juhum1/EID-101-C_Group3/Group3_Required_Milestones/Group3_Mechanical/Group3_CAD.md

Our full CAD can be found at the following link:

https://cad.onshape.com/documents/2cab0b1e455cba97361a3ce3/w/f83fcec6a3bfe1c423a4c53c/e/1c15cd89dac8a27a22d52bf7
