juhum1/EID-101-C_Group3/Group3_Deliverables/Group3_Gantt_Chart.md

| **Task** | **Duration (Weeks)** | **Week 1** | **Week 2** | **Week 3** | **Week 4** | **Week 5** |
|---|---|---|---|---|---|---|
| Research Components | 1 Week | X | | | | |
| Assembly & Wiring | 2 Weeks | | X | X | | |
| Programming and CAD | 3 Weeks | | | X | X |  X |
| Testing & Calibration | 2 Weeks | | | | X |  X |
