juhum1/EID-101-C_Group3/Group3_Required_Milestones/Group3_Electrical/schematic.pdf

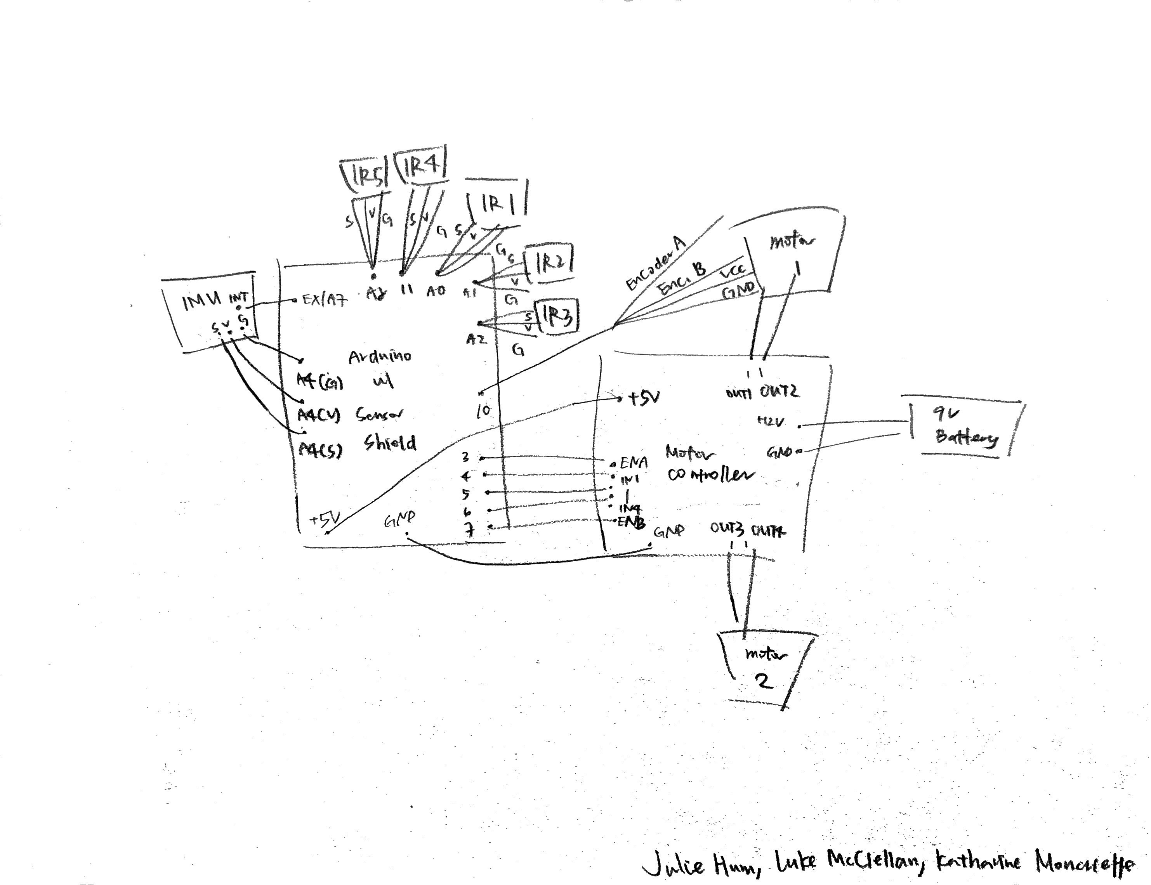
[picture p6: page 1]
