juhum1/EID-101-C_Group3/Group3_Required_Milestones/Group3_Programming/Group3_Programming_2/statemachine2.pdf

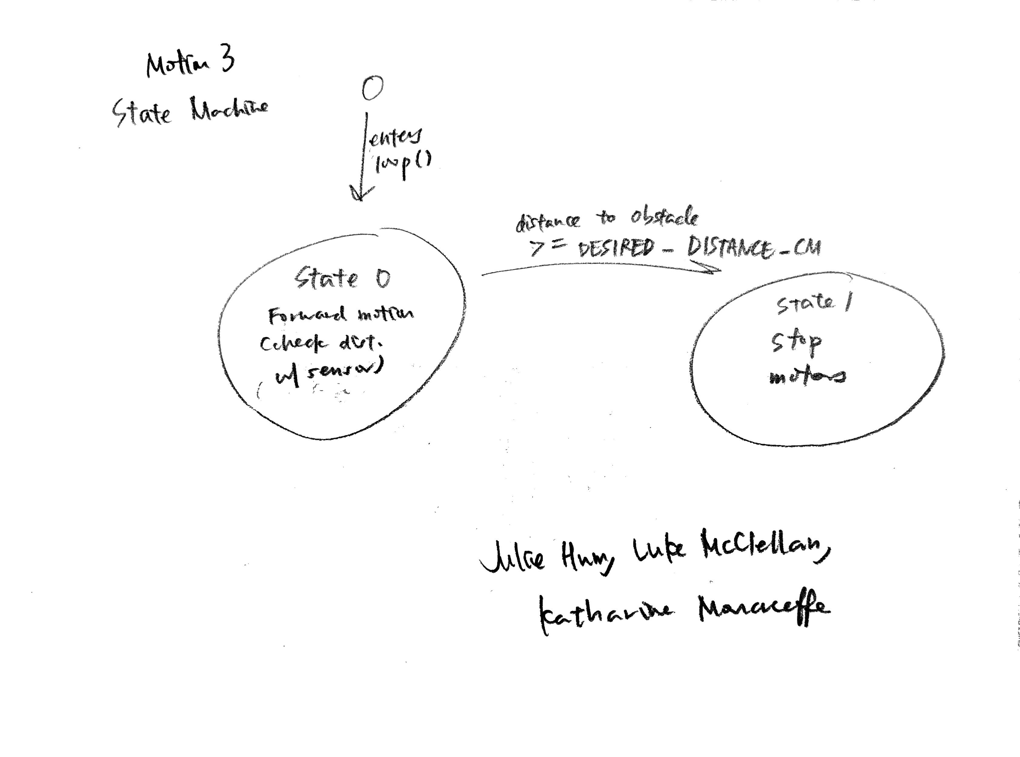
[picture p7: page 1]
