juhum1/EID-101-C_Group3/Group3_Required_Milestones/Group3_Line_Following/Group3_Line_Following_2/algorithm/stateMachine.pdf

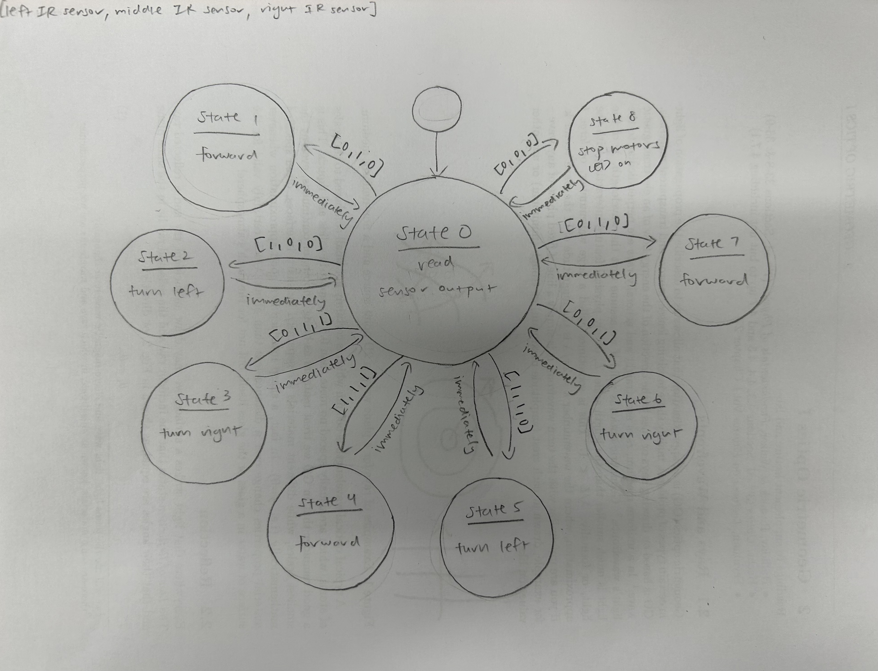
[picture p8: page 1]
