juhum1/EID-101-C_Group3/Group3_Required_Milestones/Group3_Management/Group3_BOM.md

| **Component** | **Quantity** | **Approx. Unit Price (USD)** | **Total Price (USD)** |
|---|---|---|---|
| **IR Reflective Sensors**  | 5 | $2 | $10 |
| **Optical Interrupt Sensors** | 2 | $3 | $6 |
| **VL53L0 Lidar Sensor** | 1 | $15 | $15 |
| **HC-SR04 Ultrasonic Sensor** | 1 | $2 | $2 |
| **MPU6050 IMU** | 1 | $5 | $5
