juhum1/EID-101-C_Group3/Group3_Required_Milestones/Group3_Mechanical/3DPrint/3DPrintedPart.stl

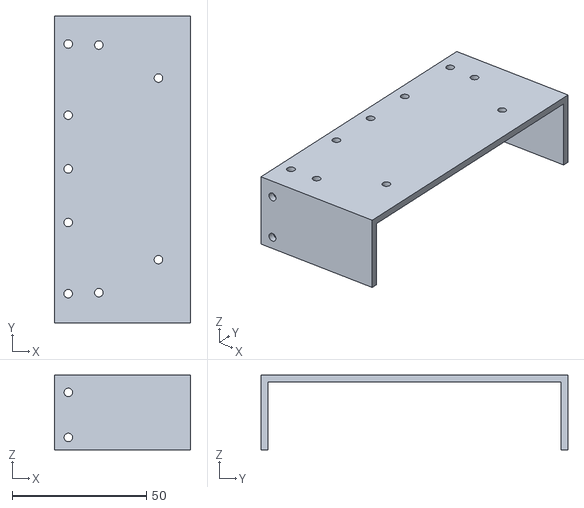
[picture p9: CAD file, 2024-12-13]
Group3_Required_Milestones/Group3_Mechanical/3DPrint/3DPrintedPart.stl
50.8 x 114.4 x 27.9
