juhum1/EID-101-C_Group3/Group3_Required_Milestones/Group3_Mechanical/LaserCut/LaserCutPart.dxf

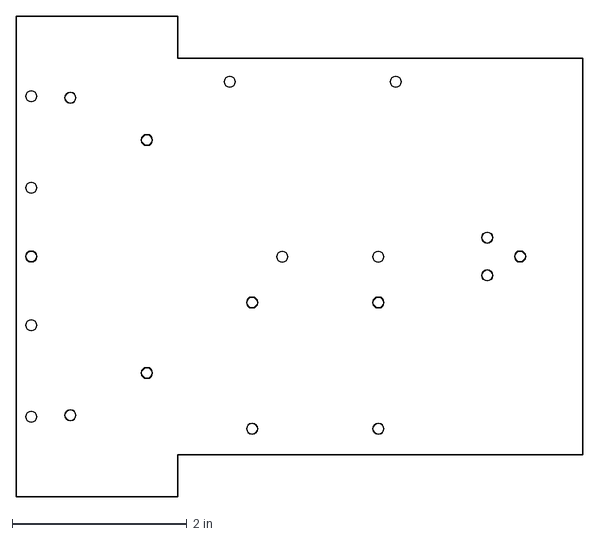
[picture p10: CAD file, 2024-12-13]
Group3_Required_Milestones/Group3_Mechanical/LaserCut/LaserCutPart.dxf
6.48 x 5.50 in
