juhum1/EID-101-C_Group3/Group3_Journals/designJournalLukeMcConnell3.md

Design Journal  
Luke McConnell  
Oct. 23  
We divided the tasks for the midterm presentation and started working on our Gantt chart and design matrix. We wrote the problem statement.   
  
Oct. 24  
We began sketching and doing background research to develop ideas for our design, and finished the design matrix and Gantt chart.   
  
Oct. 31  
We made our midterm presentation and modified our problem statement.   
  
Nov. 6  
I built the cardboard chassis for the car and we started adding components to it, including the motors, Arduino/sensor shield, and motor controller.   
  
Nov. 7  
I finished the CAD of the cardboard chassis and we wired the motor controller and other components.   
  
Nov. 14  
I continued working on the CAD of the car, wrote code for integrating the IR sensor, and tuned the potentiometer to make the car stop before the wall.   
  
Nov. 21  
We added 2 more IR sensors to the car and wired them to the system. I added to the CAD and adjusted the placement of the sensors to make them closer to the ground. Started working on CAD files for 3D print/laser cut.   
  
Nov. 25  
I finished my work on the CAD files for the 3D printed motor/sensor mount and laser cut chassis and we worked on completing the tasks necessary for the design sprint.   
  
Nov. 26  
We continued working on the design sprint tasks. Started to assemble the car using the 3D printed/laser cut components.  
  
Dec 3.  
Found out that the car was too big - began to redesign a new laser cut chassis which would fit the size requirements.  
  
Dec. 12  
I continued to polish up the final CAD to be submitted and made adjustments to the laser cut part to fit the size requirements, and worked on paperwork for the final project report.
