juhum1/EID-101-C_Group3/Group3_Required_Milestones/Group3_Mechanical/3DPrint/3DPrintedPart3View.pdf

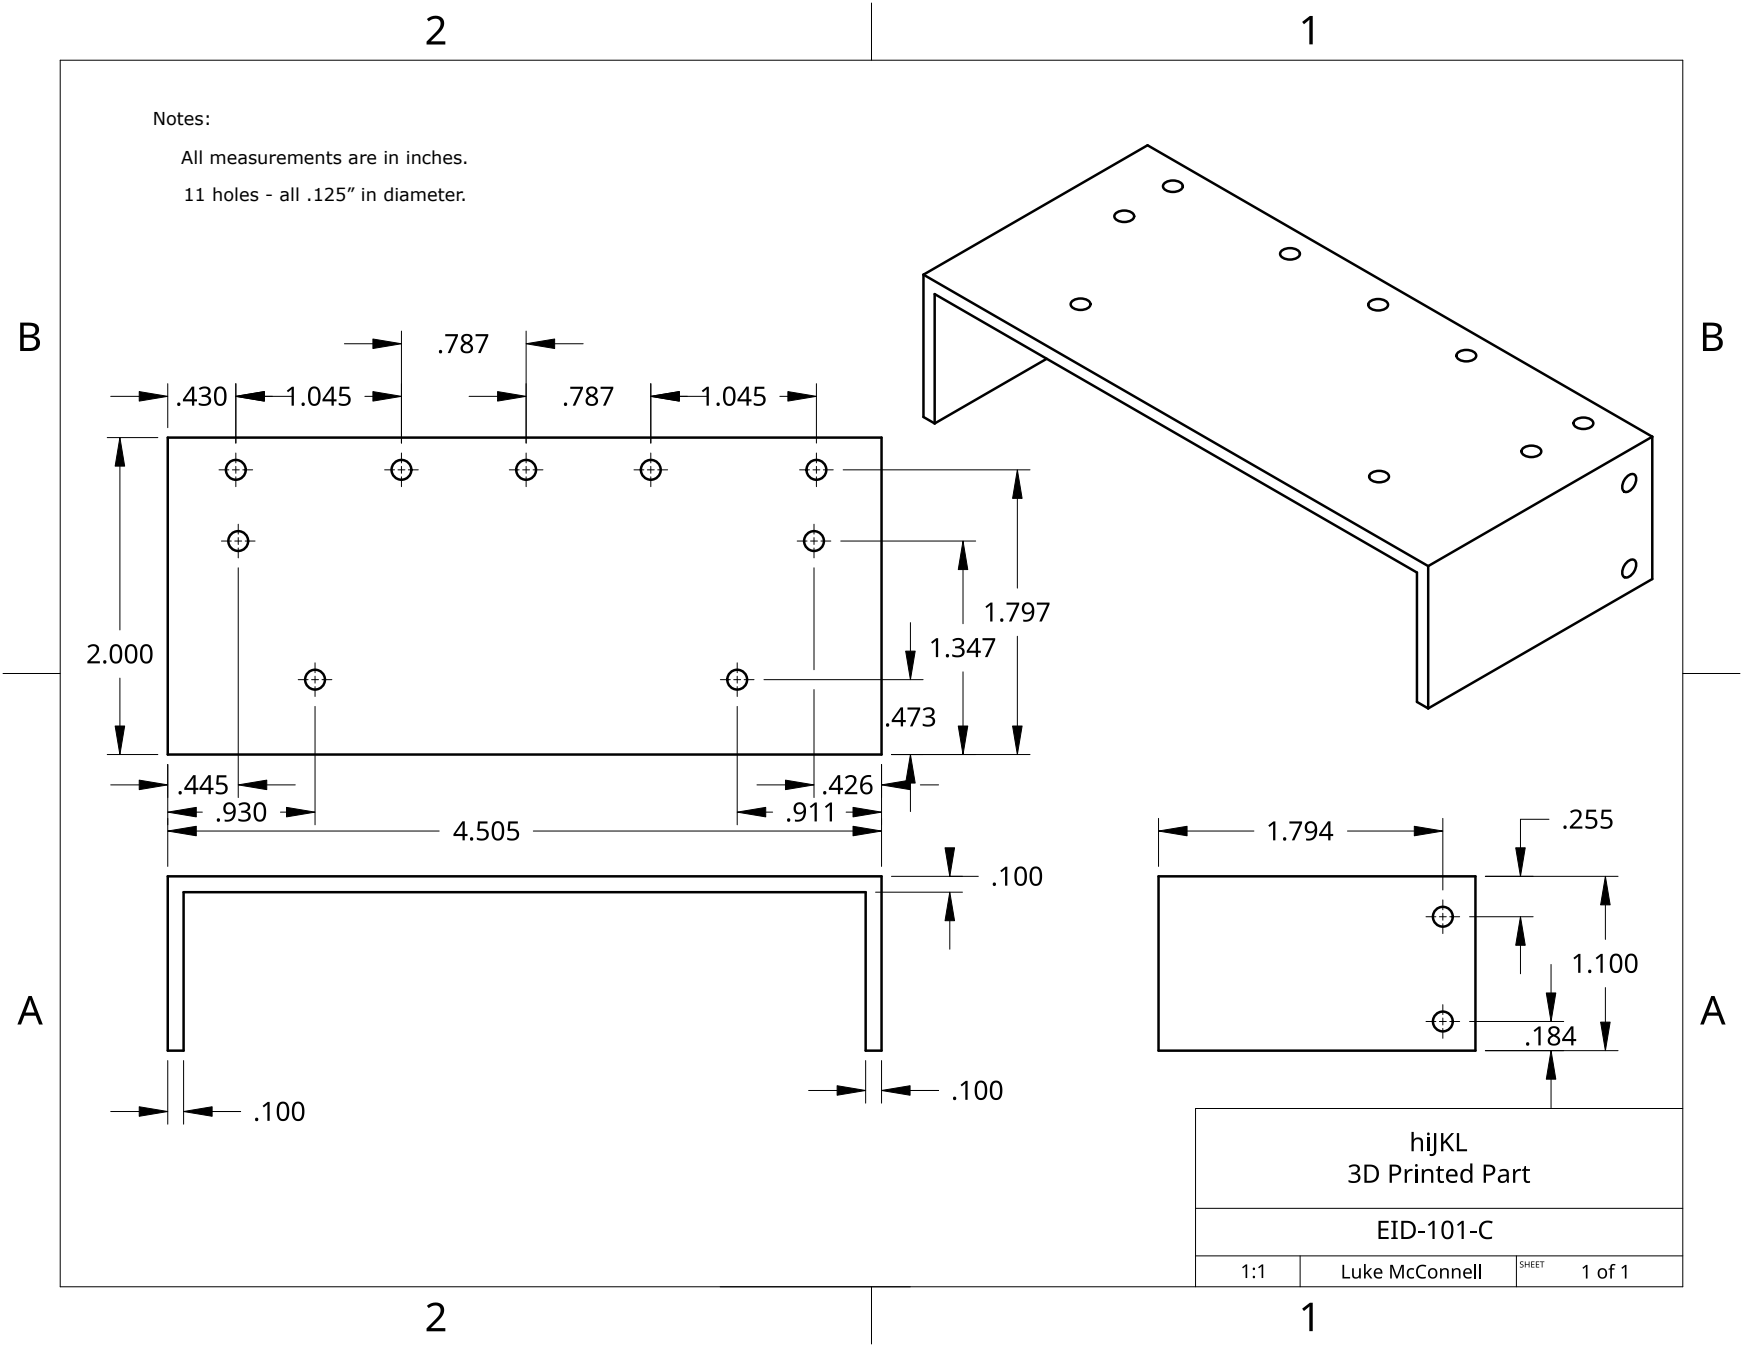
[picture p11: page 1]
