juhum1/EID-101-C_Group3/Group3_Required_Milestones/Group3_Mechanical/LaserCut/LaserCut3View.pdf

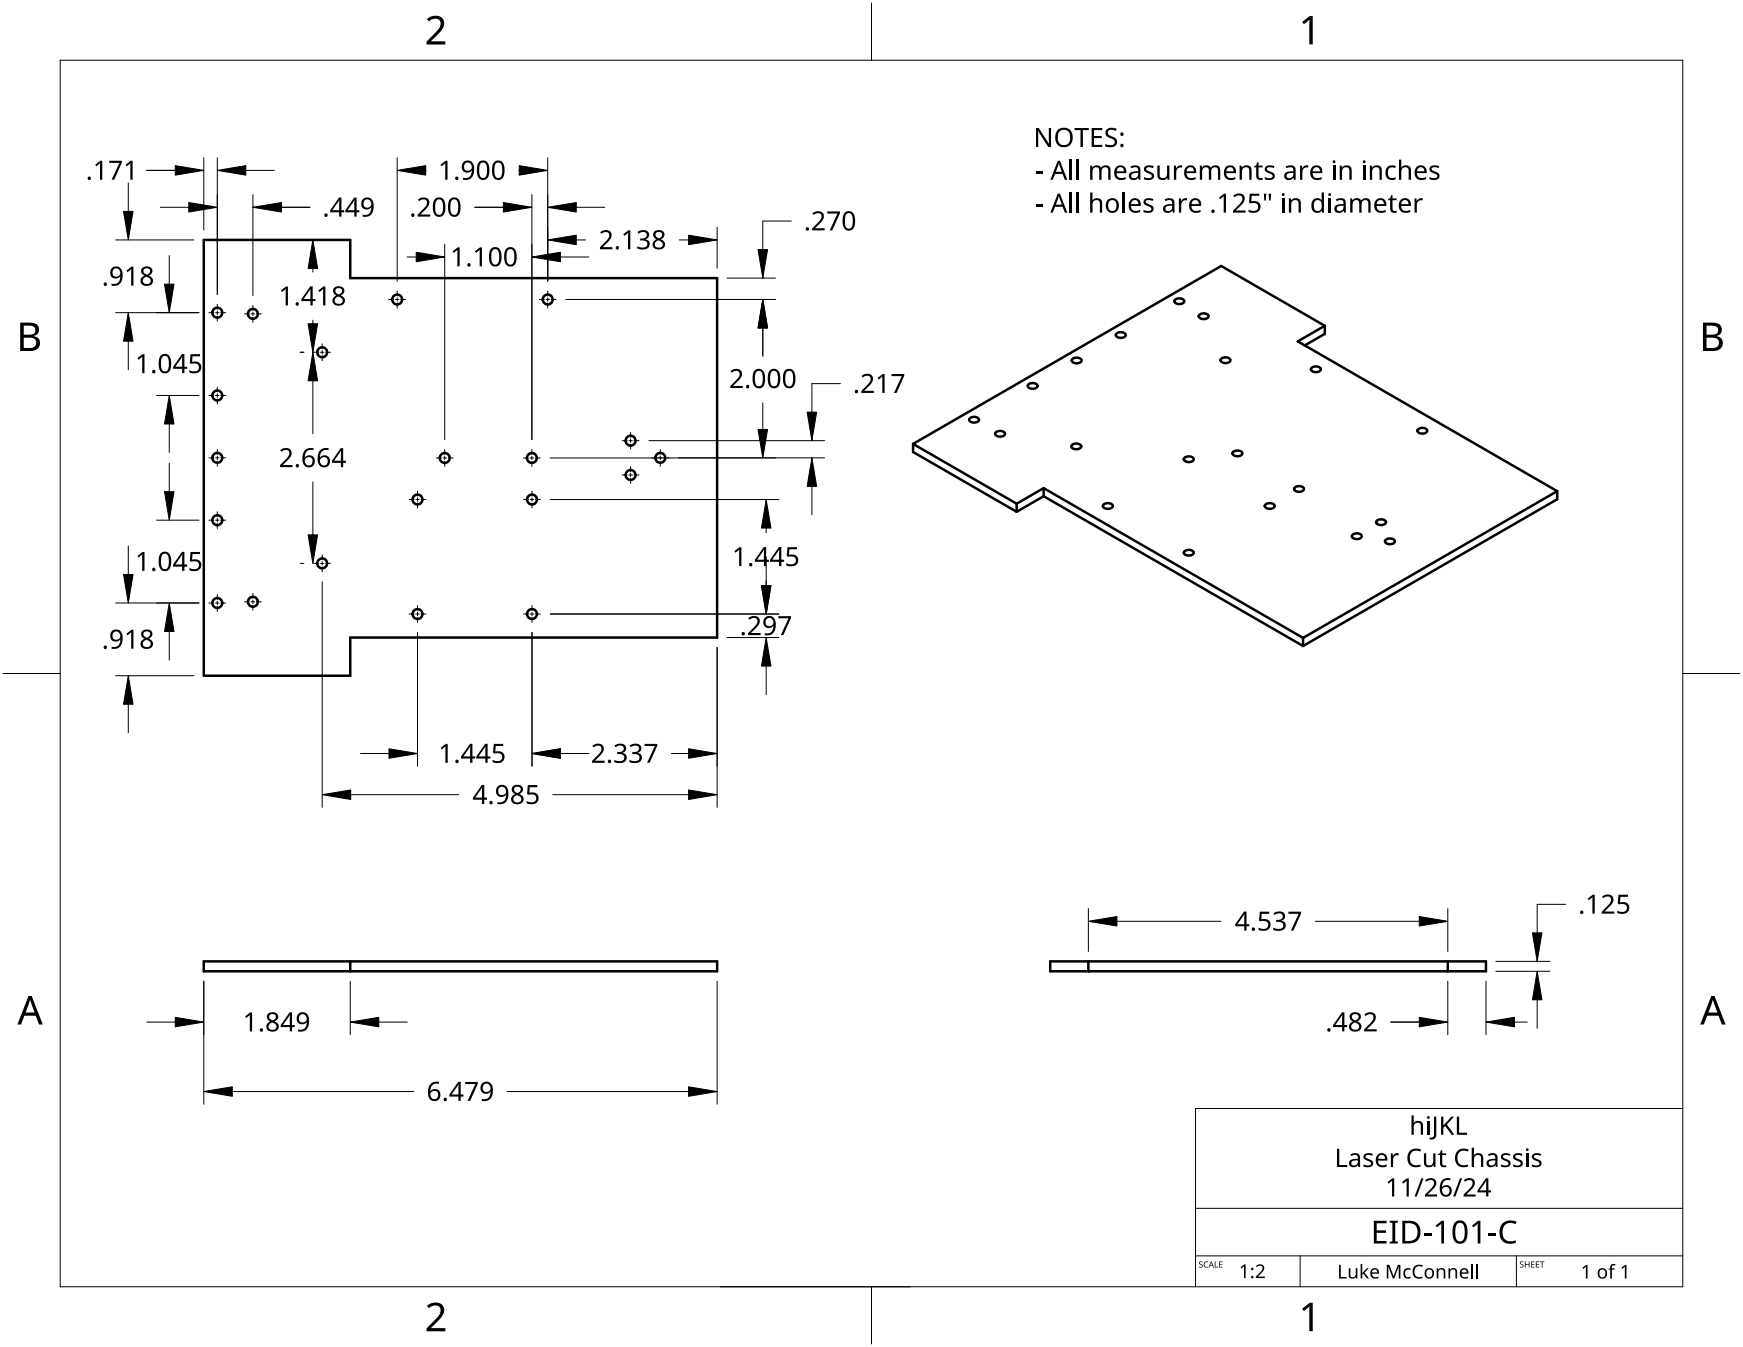
[picture p12: page 1]
