juhum1/EID-101-C_Group3/Group3_Required_Milestones/Group3_Line_Following/Group3_Line_Following_1/code/lineFollowingA.ino

#include <rcc.h>
#include <Wire.h>

//pin definitions
#define ENA 3
#define IN1 4
#define IN2 5
#define IN3 6
#define IN4 7
#define ENB 9
#define IR_left A0
#define IR_middle A6
#define IR_right A3
#define LED 12

//speed-related variables
#define normalspeed 130
#define gap 80
#define turnspeed 150

//angle-related variables
float desired_angle = 0;
float current_angle = 0;

//time-related variables
unsigned long cur = 0;
unsigned long prev = 0;
unsigned long time_passed = 0;

MPU6050 imu;

void rotate(float desired_angle, String direction)
{
  imu.update();

  int direction_num;

  //clockwise
  if (direction == "CW") {
    motorDirection("right");
    setMotorSpeed(normalspeed, normalspeed);
    direction_num = 1;

    Serial.println("CW");
  }

  //counterclockwise
  if (direction == "CCW") {
    motorDirection("left");
    setMotorSpeed(normalspeed, normalspeed);
    direction_num = -1;

    Serial.println("CCW");
  }

  prev = millis();

  while (abs(current_angle) < abs(desired_angle)) {
    //if current angle is less than the desired angle, keep rotating
    imu.update();

    cur = millis();
    time_passed = (cur - prev) / 1000.0; //find time passed in seconds
    prev = cur;

    current_angle += imu.getAngVelZ() * time_passed * direction_num; //calculate current angle

    Serial.print("Angle: ");
    Serial.println(current_angle);
  }
  //if current angle reaches desired angle, stop rotating
  stopMotors();
}

void sensorOutput() {
  int left = digitalRead(IR_left);
  int middle = digitalRead(IR_middle);
  int right = digitalRead(IR_right);
  digitalWrite(LED, LOW);

  //ENA Wheel needs higher speed than ENB wheel to run at the same speed
  if (left == LOW && middle == LOW && right == LOW) {
    //if all sensors low for 2 seconds, rotate 180)
    cur = millis();
    if ((cur - prev) > 7000) {
      rotate(180.0, "CW");
    }

    //if all sensors low for 5 seconds, LED will be set to HIGH
    cur = millis();
    if ((cur - prev) > 10000) {
      digitalWrite(LED, HIGH);
    }
    prev = cur;
    stopMotors();
  }
  if (left == LOW && middle == LOW && right == HIGH) {
    setMotorSpeed(normalspeed +gap, turnspeed);
  }
  if (left == LOW && middle == HIGH && right == LOW) {
    setMotorSpeed(normalspeed +gap, normalspeed);
  }
  if (left == HIGH && middle == LOW && right == LOW) {
    setMotorSpeed(turnspeed +gap, normalspeed);
  }
  if (left == LOW && middle == HIGH && right == HIGH) {
    setMotorSpeed(normalspeed +gap, turnspeed);
  }
  if (left == HIGH && middle == LOW && right == HIGH) {
    setMotorSpeed(normalspeed +gap, normalspeed);
  }
  if (left == HIGH && middle == HIGH && right == LOW) {
    setMotorSpeed(turnspeed + gap, normalspeed);
  }
  if (left == HIGH && middle == HIGH && right == HIGH) {
    setMotorSpeed(normalspeed +gap, normalspeed);  
  }
}

void initializeMotorController() {
  pinMode(ENA, OUTPUT);
  pinMode(ENB, OUTPUT);
  pinMode(IN1, OUTPUT);
  pinMode(IN2, OUTPUT);
  pinMode(IN3, OUTPUT);
  pinMode(IN4, OUTPUT);

  digitalWrite(ENA, LOW);
  digitalWrite(ENB, LOW);
  digitalWrite(IN1, LOW);
  digitalWrite(IN2, LOW);
  digitalWrite(IN3, LOW);
  digitalWrite(IN4, LOW);

  pinMode(IR_left, INPUT);
  pinMode(IR_middle, INPUT);
  pinMode(IR_right, INPUT);

  pinMode(LED, OUTPUT);
  digitalWrite(LED, LOW);
}

void motorDirection(String direction) {
  if (direction == "forward") {
    digitalWrite(IN1, HIGH);
    digitalWrite(IN2, LOW);
    digitalWrite(IN3, HIGH);
    digitalWrite(IN4, LOW);
  }
  if (direction == "backward") {
    digitalWrite(IN1, LOW);
    digitalWrite(IN2, HIGH);
    digitalWrite(IN3, LOW);
    digitalWrite(IN4, HIGH);
  }
  if (direction == "left") {
    digitalWrite(IN1, LOW);
    digitalWrite(IN2, HIGH);
    digitalWrite(IN3, HIGH);
    digitalWrite(IN4, LOW);
  }
  if (direction == "right") {
    digitalWrite(IN1, HIGH);
    digitalWrite(IN2, LOW);
    digitalWrite(IN3, LOW);
    digitalWrite(IN4, HIGH);
  }
}

void setMotorSpeed(int speedA, int speedB) {
  analogWrite(ENA, speedA);
  analogWrite(ENB, speedB);
}

void stopMotors() {
  digitalWrite(ENA, LOW);
  digitalWrite(ENB, LOW);
}

void setup() {
  initializeMotorController();
  motorDirection("forward");
//  setMotorSpeed(normalspeed, normalspeed);
}

void loop() {
  sensorOutput();
}
