juhum1/EID-101-C_Group3/(commit log)

2024-11-25 11/7 code - LED firmware task
2024-11-25 11/13 code - Simple Sensor Integration
2024-11-25 corrected sensor output responses
2024-11-26 added LED visual indicator
2024-11-28 added Luke's Mechanical3 files and put all files into design-sprint-2
    [3DPrintedPart.stl, LaserCutPart.dxf]
2024-12-18 added electrical schematic as pdf
2024-12-18 moved schematic to Group3_Electrical
2024-12-18 moved schematic and statemachine
2024-12-18 moved design sprint 2 tasks into relevant directories
    [3DPrintedPart.stl, LaserCutPart.dxf]
2024-12-18 updated gantt chart and added to final report
    [3DPrintedPart.stl, LaserCutPart.dxf]
2024-12-19 added note about faulty motor controller to final report
